VK12034/pocket-flat-bolt-kit/docs/check/01_packed_iso.png

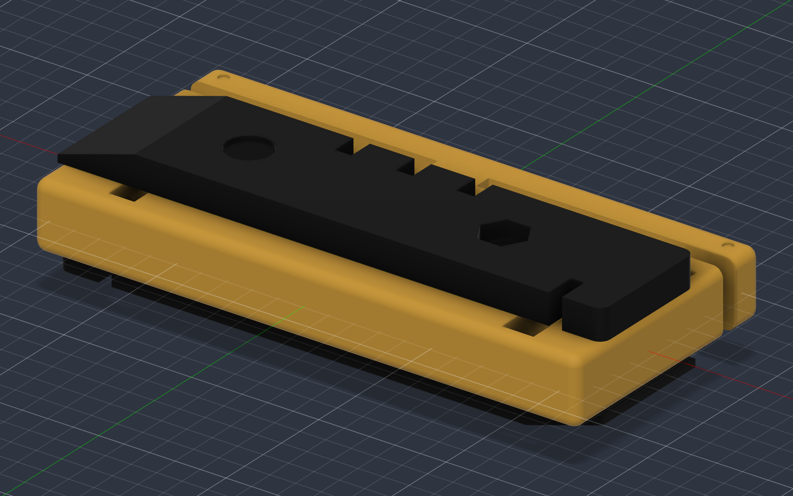
docs/check/01_packed_iso.png
