VK12034/pocket-flat-bolt-kit/docs/check/02_keys_deployed_iso.png

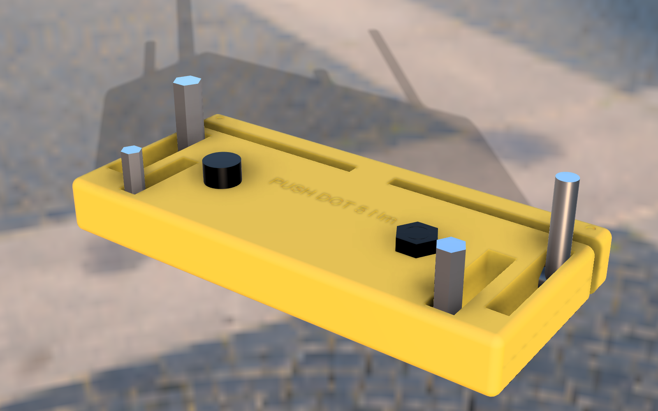
docs/check/02_keys_deployed_iso.png
