VK12034/pocket-flat-bolt-kit/docs/check/03_keys_deployed_end.png

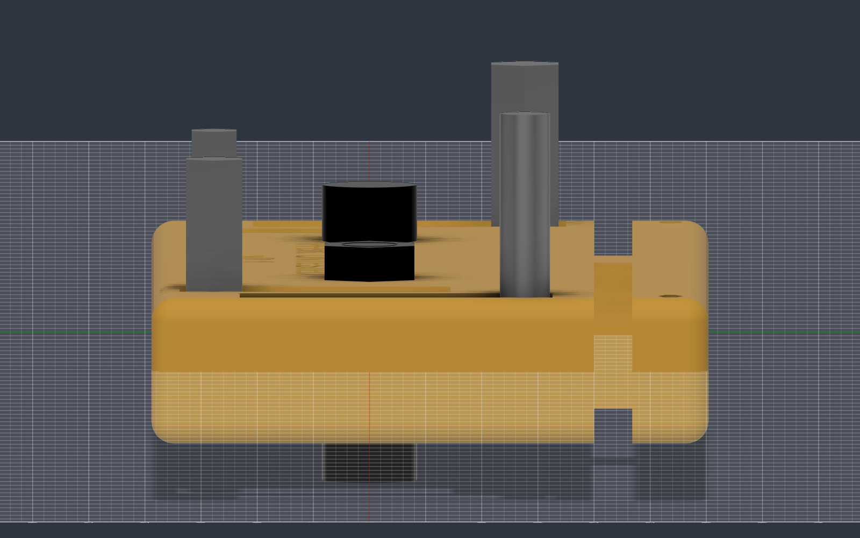
docs/check/03_keys_deployed_end.png
