VK12034/pocket-flat-bolt-kit/docs/check/04_levers_off_top.png

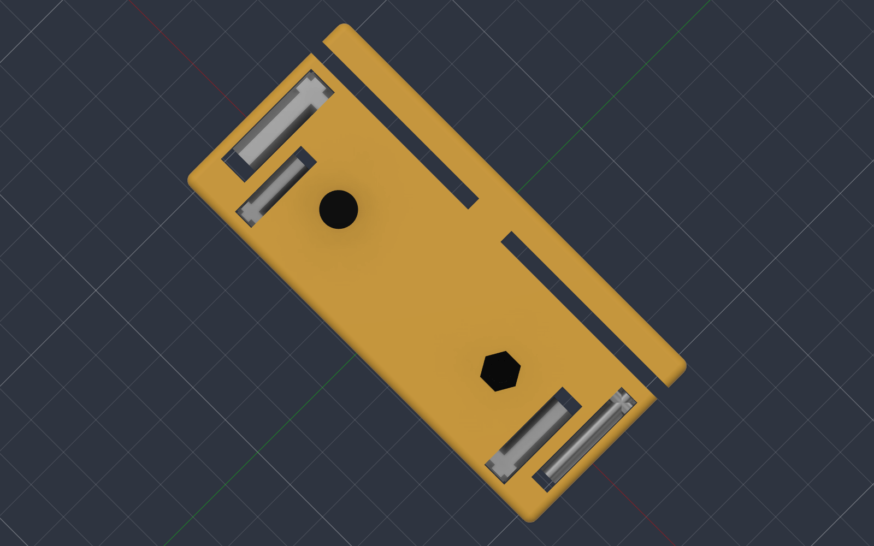
docs/check/04_levers_off_top.png
