VK12034/pocket-flat-bolt-kit/step/PFBK_v0.1_assembly.step

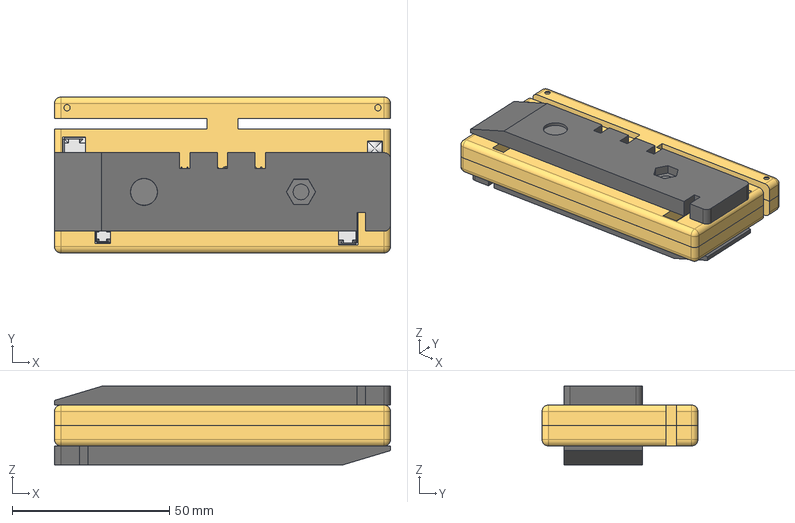
[picture p8: CAD file, 2026-11-11]
step/PFBK_v0.1_assembly.step
107.0 x 49.6 x 25.0 mm
