VK12034/pocket-flat-bolt-kit/slicing/body_bottom/x1c_petg.gcode.3mf

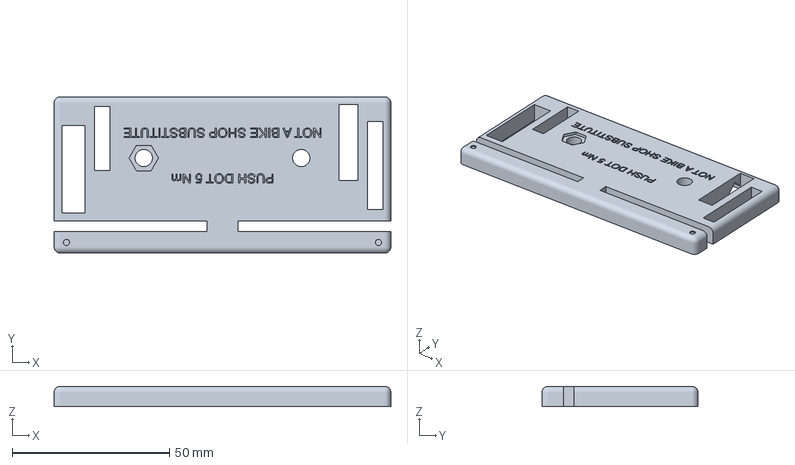
[picture p9: CAD file, 2026-11-11]
slicing/body_bottom/x1c_petg.gcode.3mf
107.0 x 49.6 x 6.50 mm
