VK12034/pocket-flat-bolt-kit/slicing/tire_lever/x1c_petg.gcode.3mf

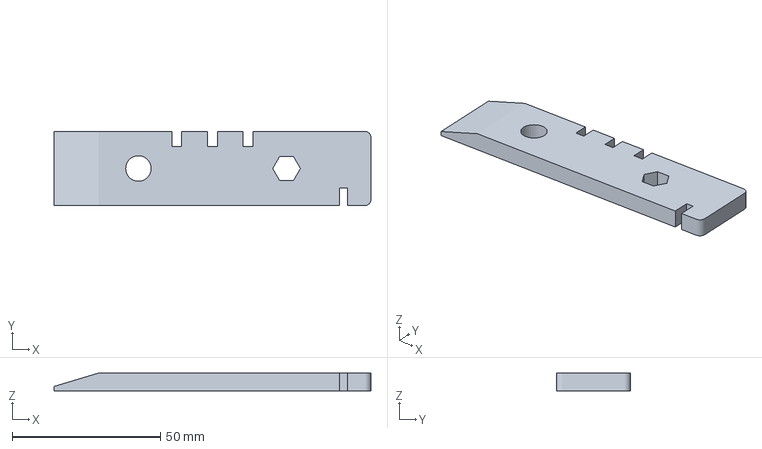
[picture p10: CAD file, 2026-11-11]
slicing/tire_lever/x1c_petg.gcode.3mf
107.0 x 25.0 x 6.00 mm
