VK12034/pocket-flat-bolt-kit/(list of files, cad)

Other CAD files:
slicing/body_top/x1c_petg.gcode.3mf
step/PFBK_v0.1_tire_lever.step
stl/PFBK_v0.1_tire_lever_print_x2.stl
step/PFBK_v0.1_body_bottom.step
step/PFBK_v0.1_body_top.step
cad/PFBK_v0.1.f3d
stl/PFBK_v0.1_assembly.stl
stl/PFBK_v0.1_body_bottom.stl
stl/PFBK_v0.1_body_top.stl
